kdurf15/KDurf-Senior-Design-Project/README.md

# KDurf-Senior-Design-Project
**DIGITAL SIMULATION**

For my (Kevin Durfee's) Senior Design project, I have created and implemented an educational simulation of the Safety Loop system for the FSAE EV cars, based on the 2023 Formula Hybrid SAE + Electric ruleset. 

Shown below is the FSM Diagram for the Safety Loop system, with the omission of lights/sounds. Along with it is the state transition table for the respective FSM. 

<p align="center">
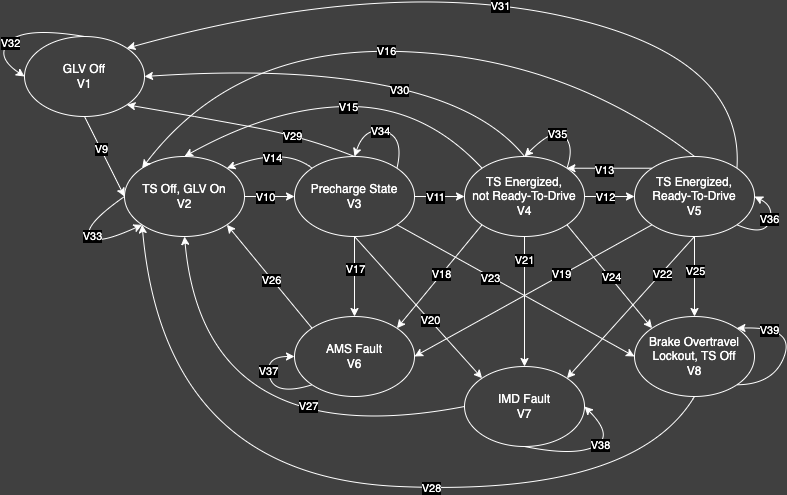
[picture p1: Safety Loop (re-colored for transparent github background).png]
Safety Loop (re-colored for transparent github background)



</p>

For those still learning about the FSAE EV Safety Loop system, or is new to the Lafayette Motorsports Team, I've provided a legend/key that explains the jargon I used.

<p align="center">

</p>

To further help understand the State Transition Table, as well as the javascript used to create the simulation, I have provided a table that briefly explains the FSM Boolean Logic used and a Truth Table that provides further examples on this Boolean Logic.

<p align="center">



</p>

Provided below is a simplified table, to help elaborate on and explain the necessary steps to transition between states and get the car ready to drive while complying with the Safety Loop/Shutdown Circuit.

<p align="center">

</p>

To provide further elaboration on the table above and create a better understanding of the simulation, there are a few features present in the simulation (either loosely explained or not explained above) that I'd like the describe. The first being the Ready-To-Drive Sound. The Ready-To-Drive Sound is 80 dbA sound that lasts for 2 seconds, that signifies that the car is ready to drive (meaning the simulation have left the TS Energized, Not Ready-To-Drive state and has entered the TS Energized, Ready-To-Drive state). This sound/buzzer is required on the car, as outlined in EV9.2 of the 2023 Formula Hybrid + Electric Rules and occurs in the simulation (hence it is encouraged to have the computer's sound on when using the simulation). Separately, in the event of any fault occuring on the car (either AMS, IMD, or Brake Overtravel Lockout), the Safety Loop/Shutdown Circuit is triggered. This results in the car, and hence the simulation, disengaging the tractive system and only keeping the GLV system on (entering the TS Off, GLV On sate). This is done for the protection of high/tractive system voltage for the driver, team, or bystanders. The GLV system remains on/energized, as it is used to power the Safety Loop/Shutdown Circuit. To help correct the car/re-energize it, all live voltage systems should bew shutdown and disengaged prior to examing the cause of the fault. Once the cause of the fault is found, the system can be re-energized using the previously outlined steps/procedures. For the simulation, if a fault occurs/fault button is engaged, the simulaton returns to the TS Off, GLV On state. From there, disengage the motor controller switch, the cockpit BRB and the TSMS. To re-energize the car, "correct/fix" the "faults" by disenganging the respective fault buttons, then procede to re-energize the car with the same steps from the TS Off, GLV On state as before.

For further clarification of the simulation, below indicates the button's appearances for the "engaged" and "not engaged" states.

<p align="center">
BRB BUTTONS
</p>

<p align="center">
  NOT ENGAGED
Safety Loop (re-colored for transparent github background)
Safety Loop (re-colored for transparent github background)
  ENGAGED
</p>

<p align="center">
GREEN BUTTONS (NON-BRB)
</p>

<p align="center">
  NOT ENGAGED
Safety Loop (re-colored for transparent github background)
Safety Loop (re-colored for transparent github background)
  ENGAGED
</p>

For ease of access, the educational Safety Loop simulation can be found here: https://kdurf15.github.io/KDurf-Senior-Design-Project/

For ease of access, the screenshot of the Safety Loop simulation 

A photo of the educational Safety Loop simulation is shown below. For ease of access, the below photo serves as a hyperlink to the simulation itself.

<p align="center">
  
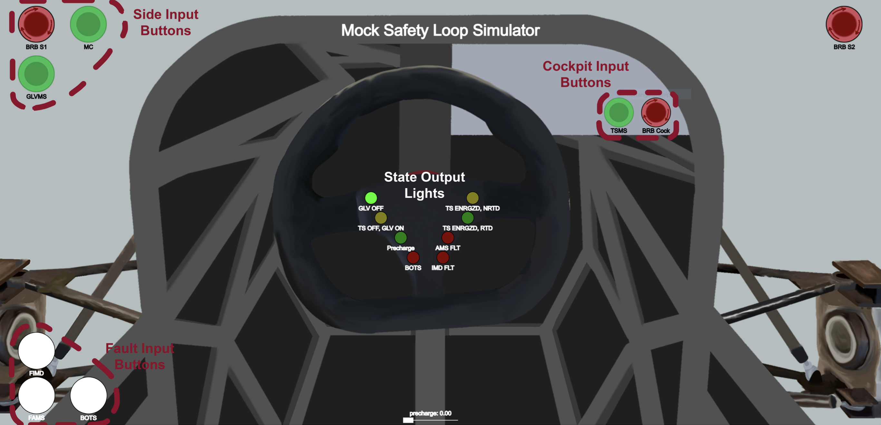
[picture p2: Labeled Sim Photo.png]
  
       
CONSIDER SWAPPED FOR NON-LABELED PHOTO FROM DESKTOP
</p>

**HARDWARE IMPLEMENTATION**

In addition to the digital/virtual simulation, I have created a physical small-scale version of the Shutdown Circuit. All features and hardware that would be on the actual Lafayette Motorsports FSAE EV car are present on the PCB test rig, just scaled down. The only exception to this would be the faults (BOTS, IMD, and AMS), which are represented via latching switches (similarly to the digital/virtual simulation). The PCB Safety Loop/Shutdown Circuit tool uses 3V and 9V batteries, on separate paths, to mimic the grounded low voltage (GLV) and tractive system (TS) of the car.

The first step when creating this PCB was to design the pre-charge circuit and circuit diagram. As a reminder, the pre-charge circuit works to prevent a sudden spike in current that would result in welding the AIRs shut (live). The time duration for the pre-charge relay, determined to be approximately 3 seconds (5 time constants), are shown below.

<p align="center">
  Target of ~99.3% Charge in 5 time constants (3 seconds)
</p>

<p align="center">
  5𝜏 = 3 seconds   →   𝜏 = 0.6 seconds
</p>

<p align="center">
  𝜏 = RC
</p>
  
<p align="center">
  Motor Inverter DC Bus Capacitance, C = 300 μF
</p>

<p align="center">
  R = 𝜏/C = (0.6 seconds)/(300 μF) = 2kΩ
  
</p>

<p align="center">
  Max current target, based on full ~300V
</p>
<p align="center">
  (300V)/(2 kΩ) = 0.15 A
  
</p>

<p align="center">
  Power Dissipated through Resistor
</p>

<p align="center">
  (0.15^2 A)*(2 kΩ) = 45 W Max
</p>

The pre-charge time delay, both for the small-scale PCB safety loop implementation and the physical implementation in the full-scale car, will use a 555 timer. The safety loop circuit, including the 555 timer, was initially designed in falstad. The falstad is shown below and can be found here: https://tinyurl.com/ctu5a7be

<p align="center">
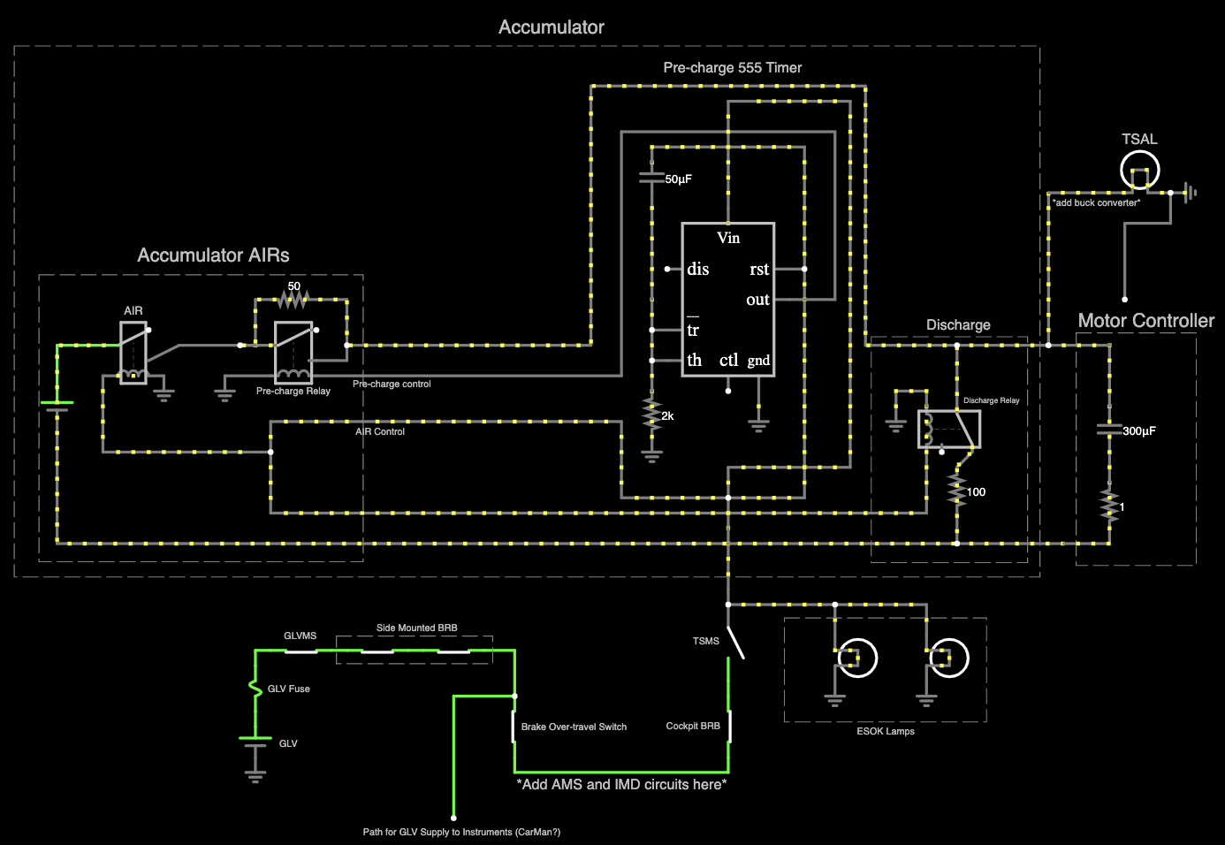
[picture p3: falstad screenshot.png]
falstad screenshot

</p>

As required by the 2023 Formula SAE Hybrid + Electric rule set, the Isolation Monitoring Device (IMD) and Accumulator Management System (AMS) require latching circuits for the faults. Two suggested designs, for either fault low or high, are provided in the Appendix G of the rules and is shown below.

<p align="center">
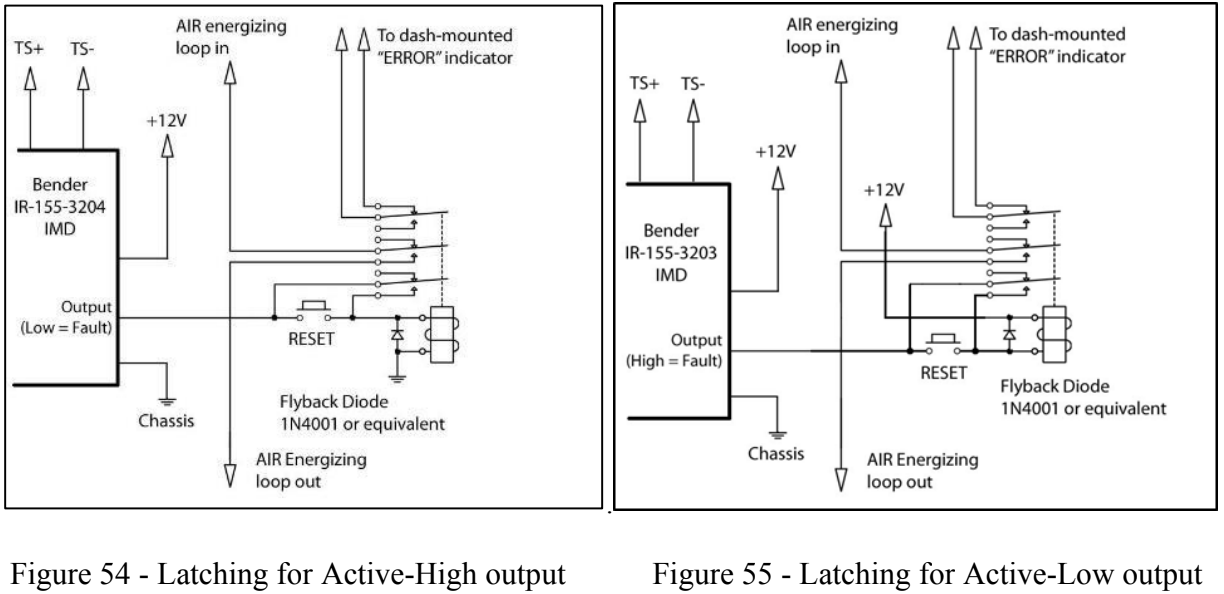
[picture p4: Appendix G Latching Circuit.png]
Falstad Latching Circuit
  
</p>

This design was considered and the corresponding design was completed in falstad. The "fault" was considered/modeled as a latching switch. The falstad is not fully rules-compliant, as it needs the addition of a flyback diode, as shown in the rules. The falstad design is shown below and can be found here: https://tinyurl.com/23wacp5r

<p align="center">
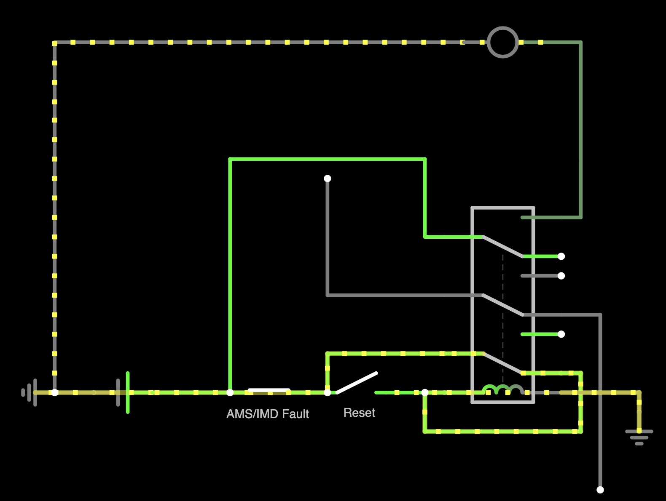
[picture p5: Falstad Latching Circuit.png]
Falstad Latching Circuit
  
</p>

The latching circuit used on the Safety Loop/Shutdown Circuit Educational PCB is simplified to the reset latching portion, providing "feedback" to require the reset switch. Given that the PCB is wired in series, pressing the fault button to simulate a fault shutdown. Due to the tactile connection of creating a fault with the fault button, a fault LED signal was not included.

This, along with the entirity of the Safety Loop/Shutdown Circuit system, was then implemented onto a PCB with silk screens to illustrate the specific wiring path, for ease of learning and understanding. A picture of the PCB design is shown below. Fusion 360 and Eagle schematic files can be found in the compressed folder, "Shutdown Circuit PCB Schematic Files," which is permalinked here: https://github.com/kdurf15/KDurf-Senior-Design-Project/blob/f66a77cbe09608431833e2ea92ca653daefc6d79/Shutdown%20Circuit%20PCB%20Schematic%20Files.zip

Below is a photo of the PCB Schematic, both normal and trimmed nets

<p align="center">
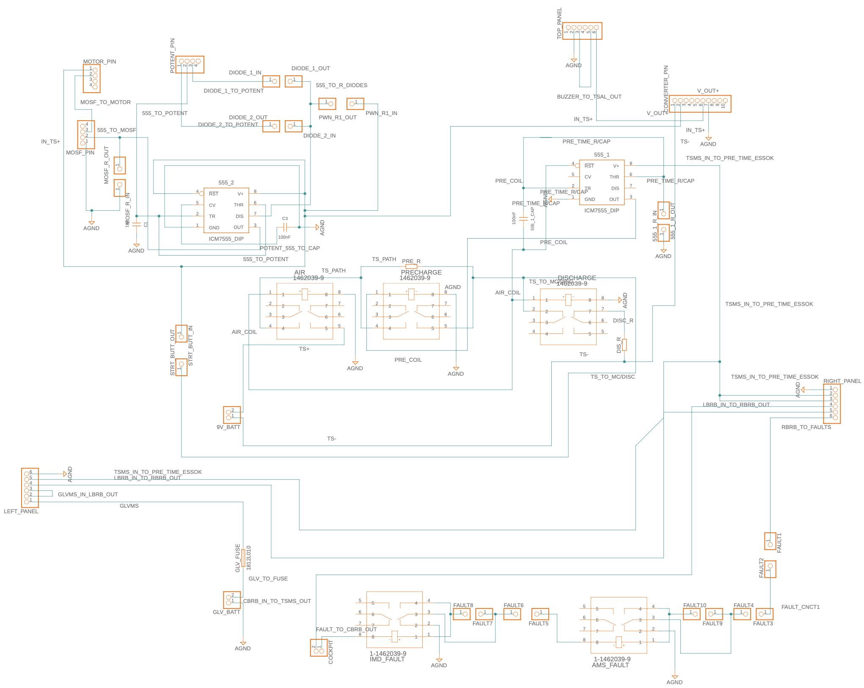
[picture p6: PCB Schematic.png]
PCB Schematic
  
</p>

<p align="center">
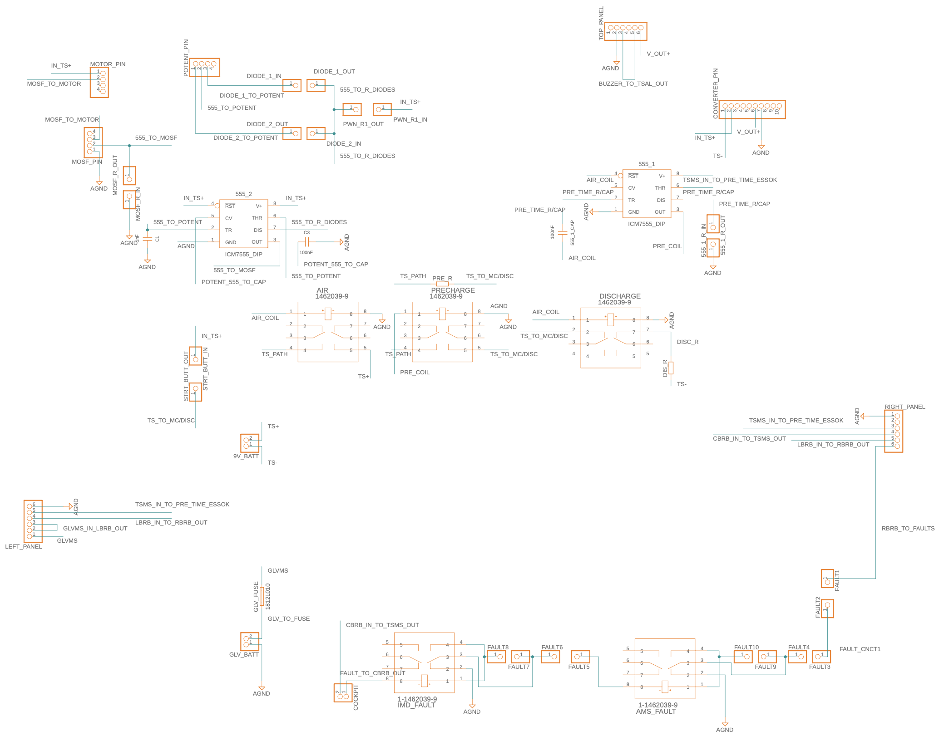
[picture p7: PCB Schematic Trimmed.png]
PCB Schematic Trimmed
  
</p>

Below shows the PCB silkscreen and physical board layout, based on the previously showed schematic

<p align="center">
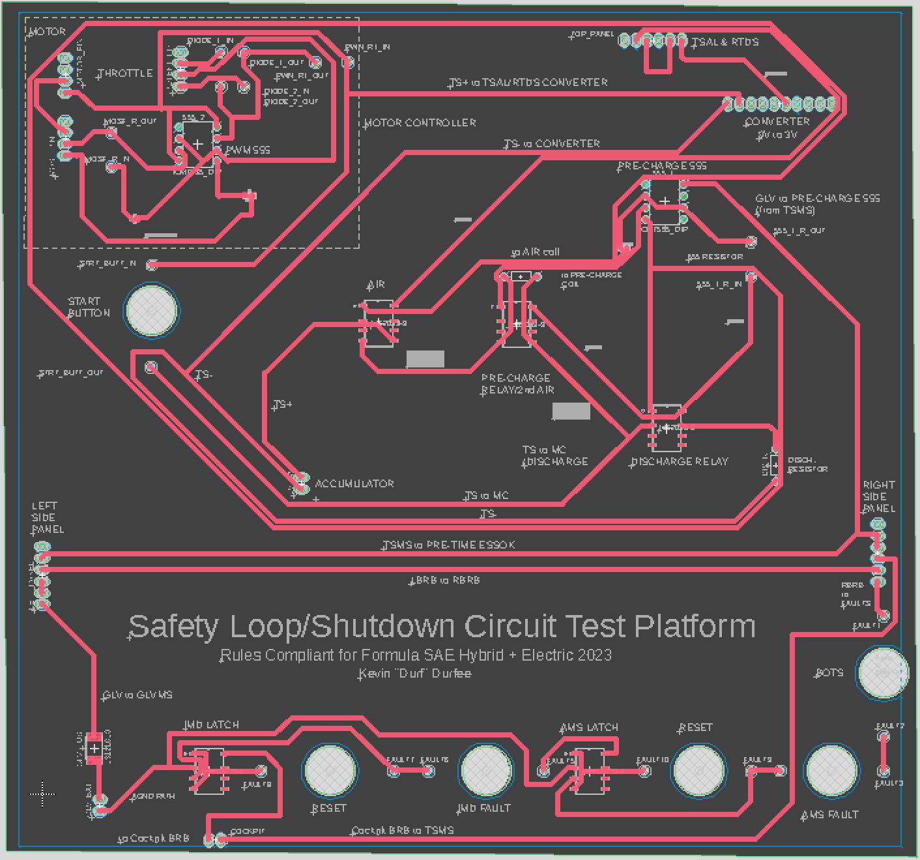
[picture p8: PCB Layout Photo.png]
PCB Layout Photo
  

</p>

<p align="center">
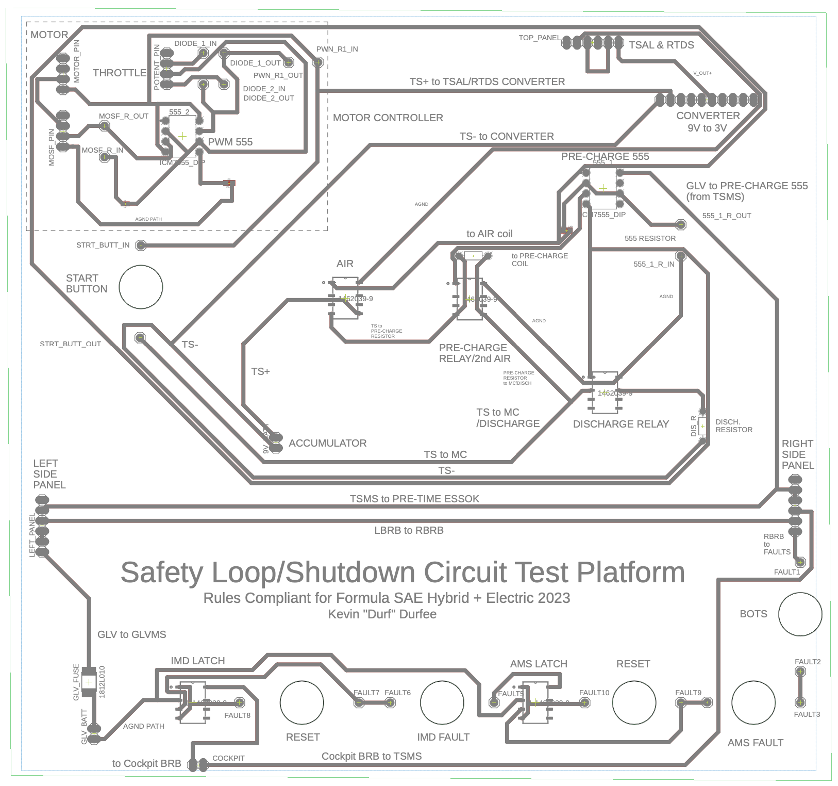
[picture p9: Silk Screen PCB Schematic.png]
Silk Screen PCB Schematic
  

</p>

Photos of the 3D model of the above PCB are shown below.

<p align="center">
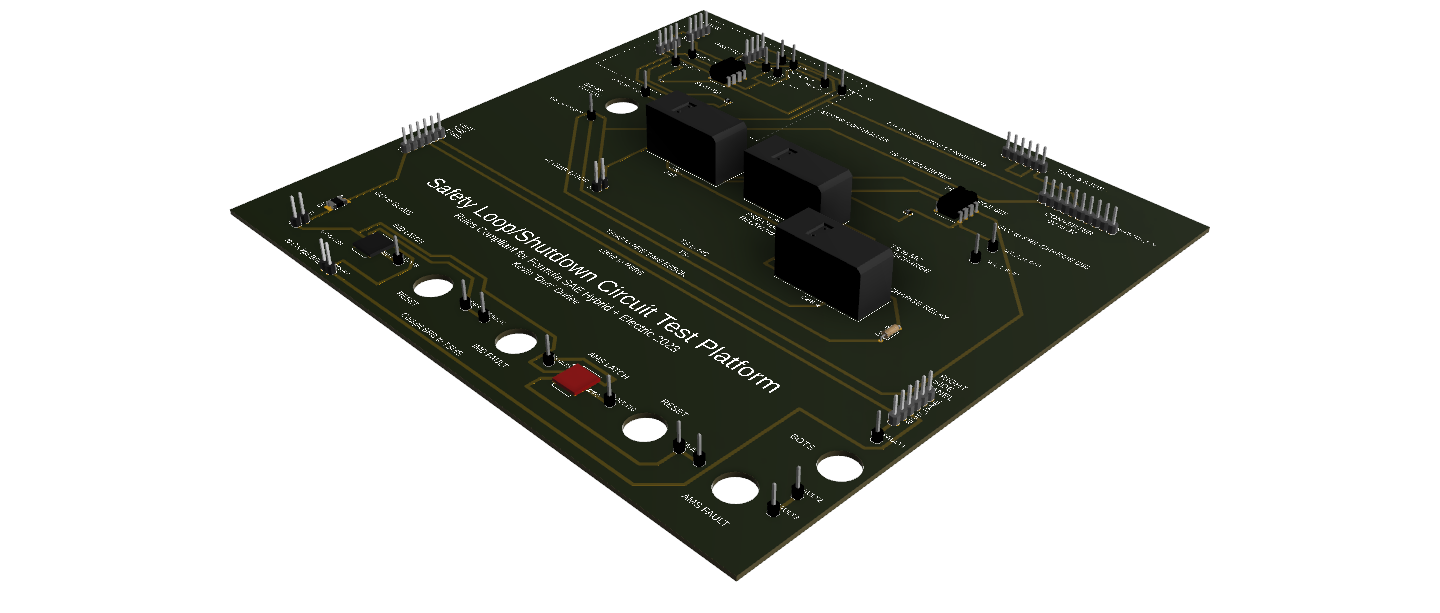
[picture p10: Durfee Safety Loop 3D PCB Photo.png]
Durfee Safety Loop 3D PCB Photo
  
</p>

<p align="center">
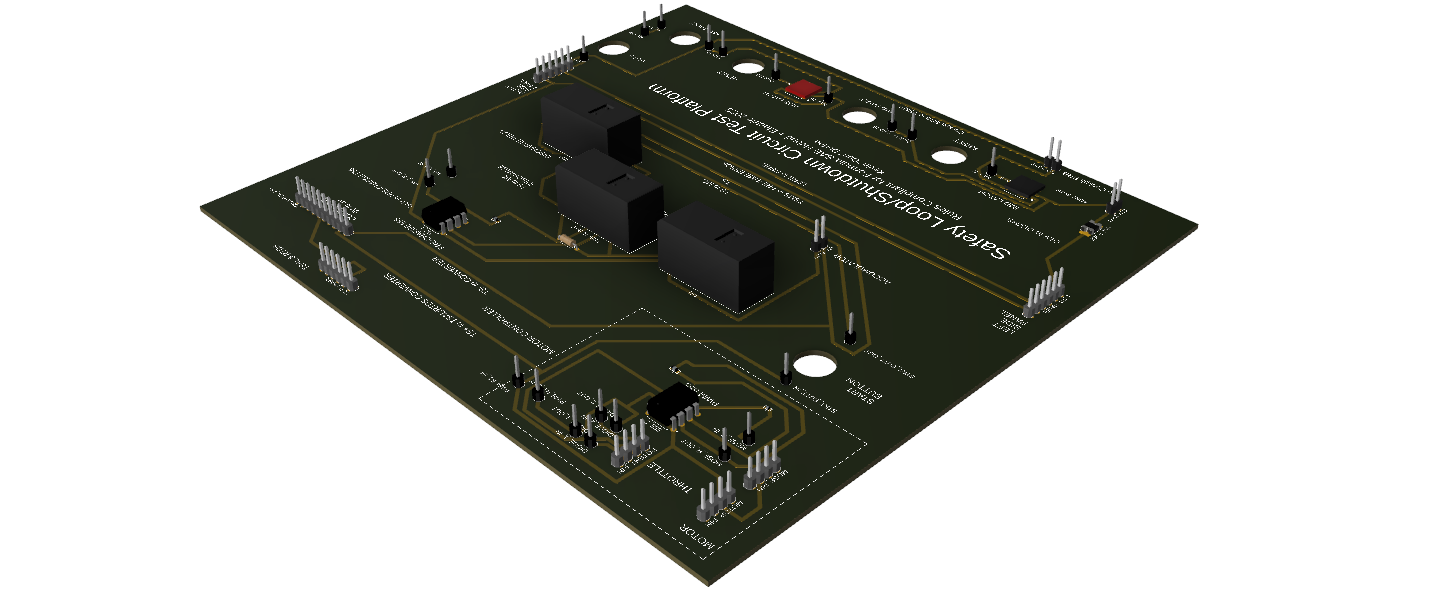
[picture p11: Durfee Safety Loop 3D PCB Photo 2.png]
Durfee Safety Loop 3D PCB Photo 2
  
</p>

For the small-scale Safety Loop/Shutdown Circuit PCB tool to appear more similar to the car's layout, buttons and switches were respectively mounted on 3D-printed "side panels" or "cockpit panels," similar to those on the car. Attachments for the rotary switches were also printed to mimic the red GLV and TS master switches. All .stl files for the 3D-printed designs are uploaded and can be found in the CAD Assembly STL Files.zip file. The completed PCB Safety Loop/Shutdown Circuit education tool is shown below.

<p align="center">
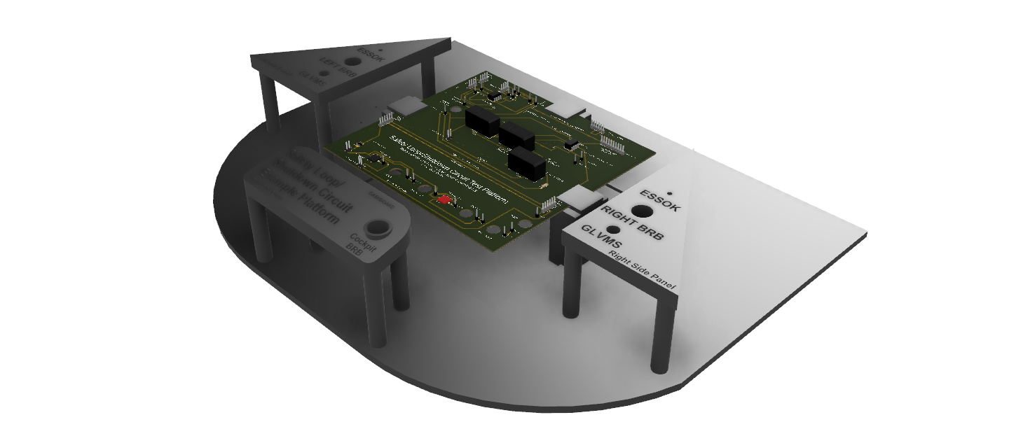
[picture p12: 3D Printed Layout.png]

</p>

After construction of the PCB, testing to check the functionality occured. Without having the proper relays in hand for the fault latching circuits, 5V relays from the 2022 ME480 Lab Rig were used. These created a significant voltage drop, causing the Safety Loop/Shutdown Circuit system to not work. Once this was bypassed, the ESSOK lights would ignite and work as intended. However, this resulted in the loss of functionality for the AMS Fault or IMD Fault buttons/features. Besides that, moving into the "high voltage" (9V) portion, I evaluated the AIRs. As seen in the wiring schematic, the Pre-Charge relay, AIR, and Discharge relay appear to be wired on the PCB incorrectly. Once corrected, by switching the connection from pad 5 to pad 2 on the Pre-Charge Relay, for example, these should work as intended. By sending the 9V+ directly after the start button, the motor and PWM Potentiometer "Motor Controller" was also tested. Despite the motor reciving approximately 9V, the motor was not spinning. Further testing to evaluate the "Motor Controller" and the pperability of the motor must occur to further find the respective issue. Below please find a photo of the first iteration of the PCB and the test rig.

<p align="center">
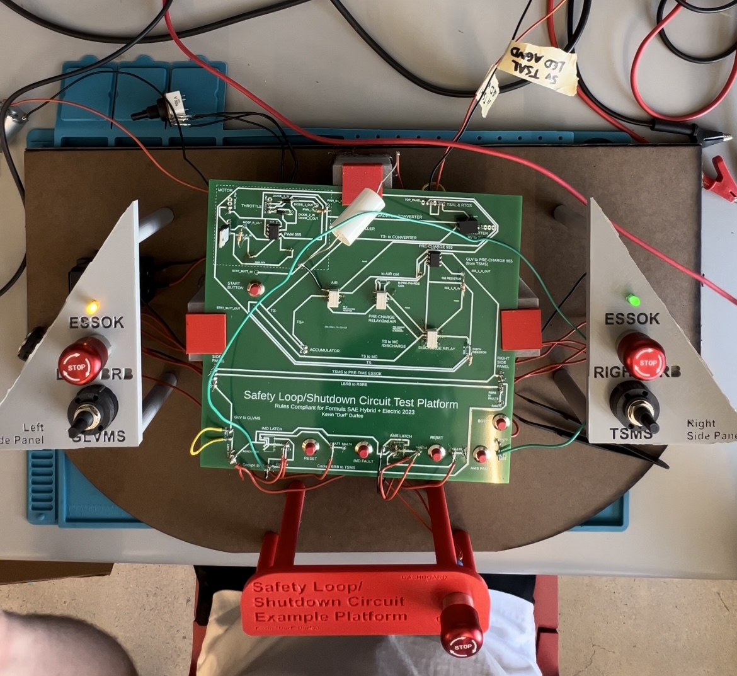
[picture p13: TestRig.jpg]
Test Rig

</p>

If any issues or questions arise with the code/simulation/hardware/project, please feel free to contact me (Kevin/Durf) at kdurf15@comcast.net or durfeekd@lafayette.edu (if my Lafayette email address is still active).
