kdurf15/KDurf-Senior-Design-Project/Sim Placeholder Image.png

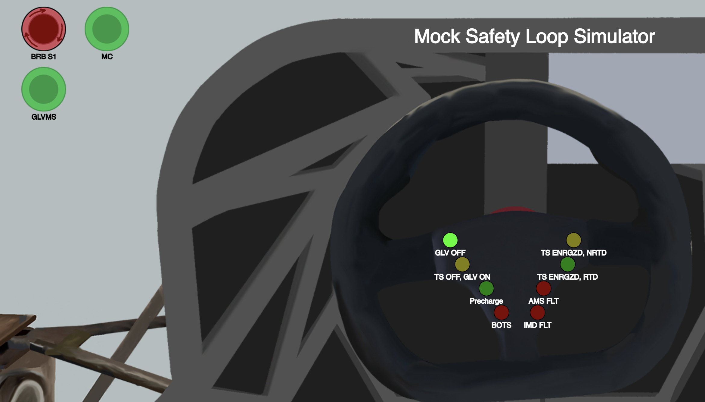
Sim Placeholder Image.png
