kdurf15/KDurf-Senior-Design-Project/Durfee_Shutdown_Circuit_PCB_Design.sch

## EAGLE design Durfee_Shutdown_Circuit_PCB_Design.sch (2023-04-27, last stored version)

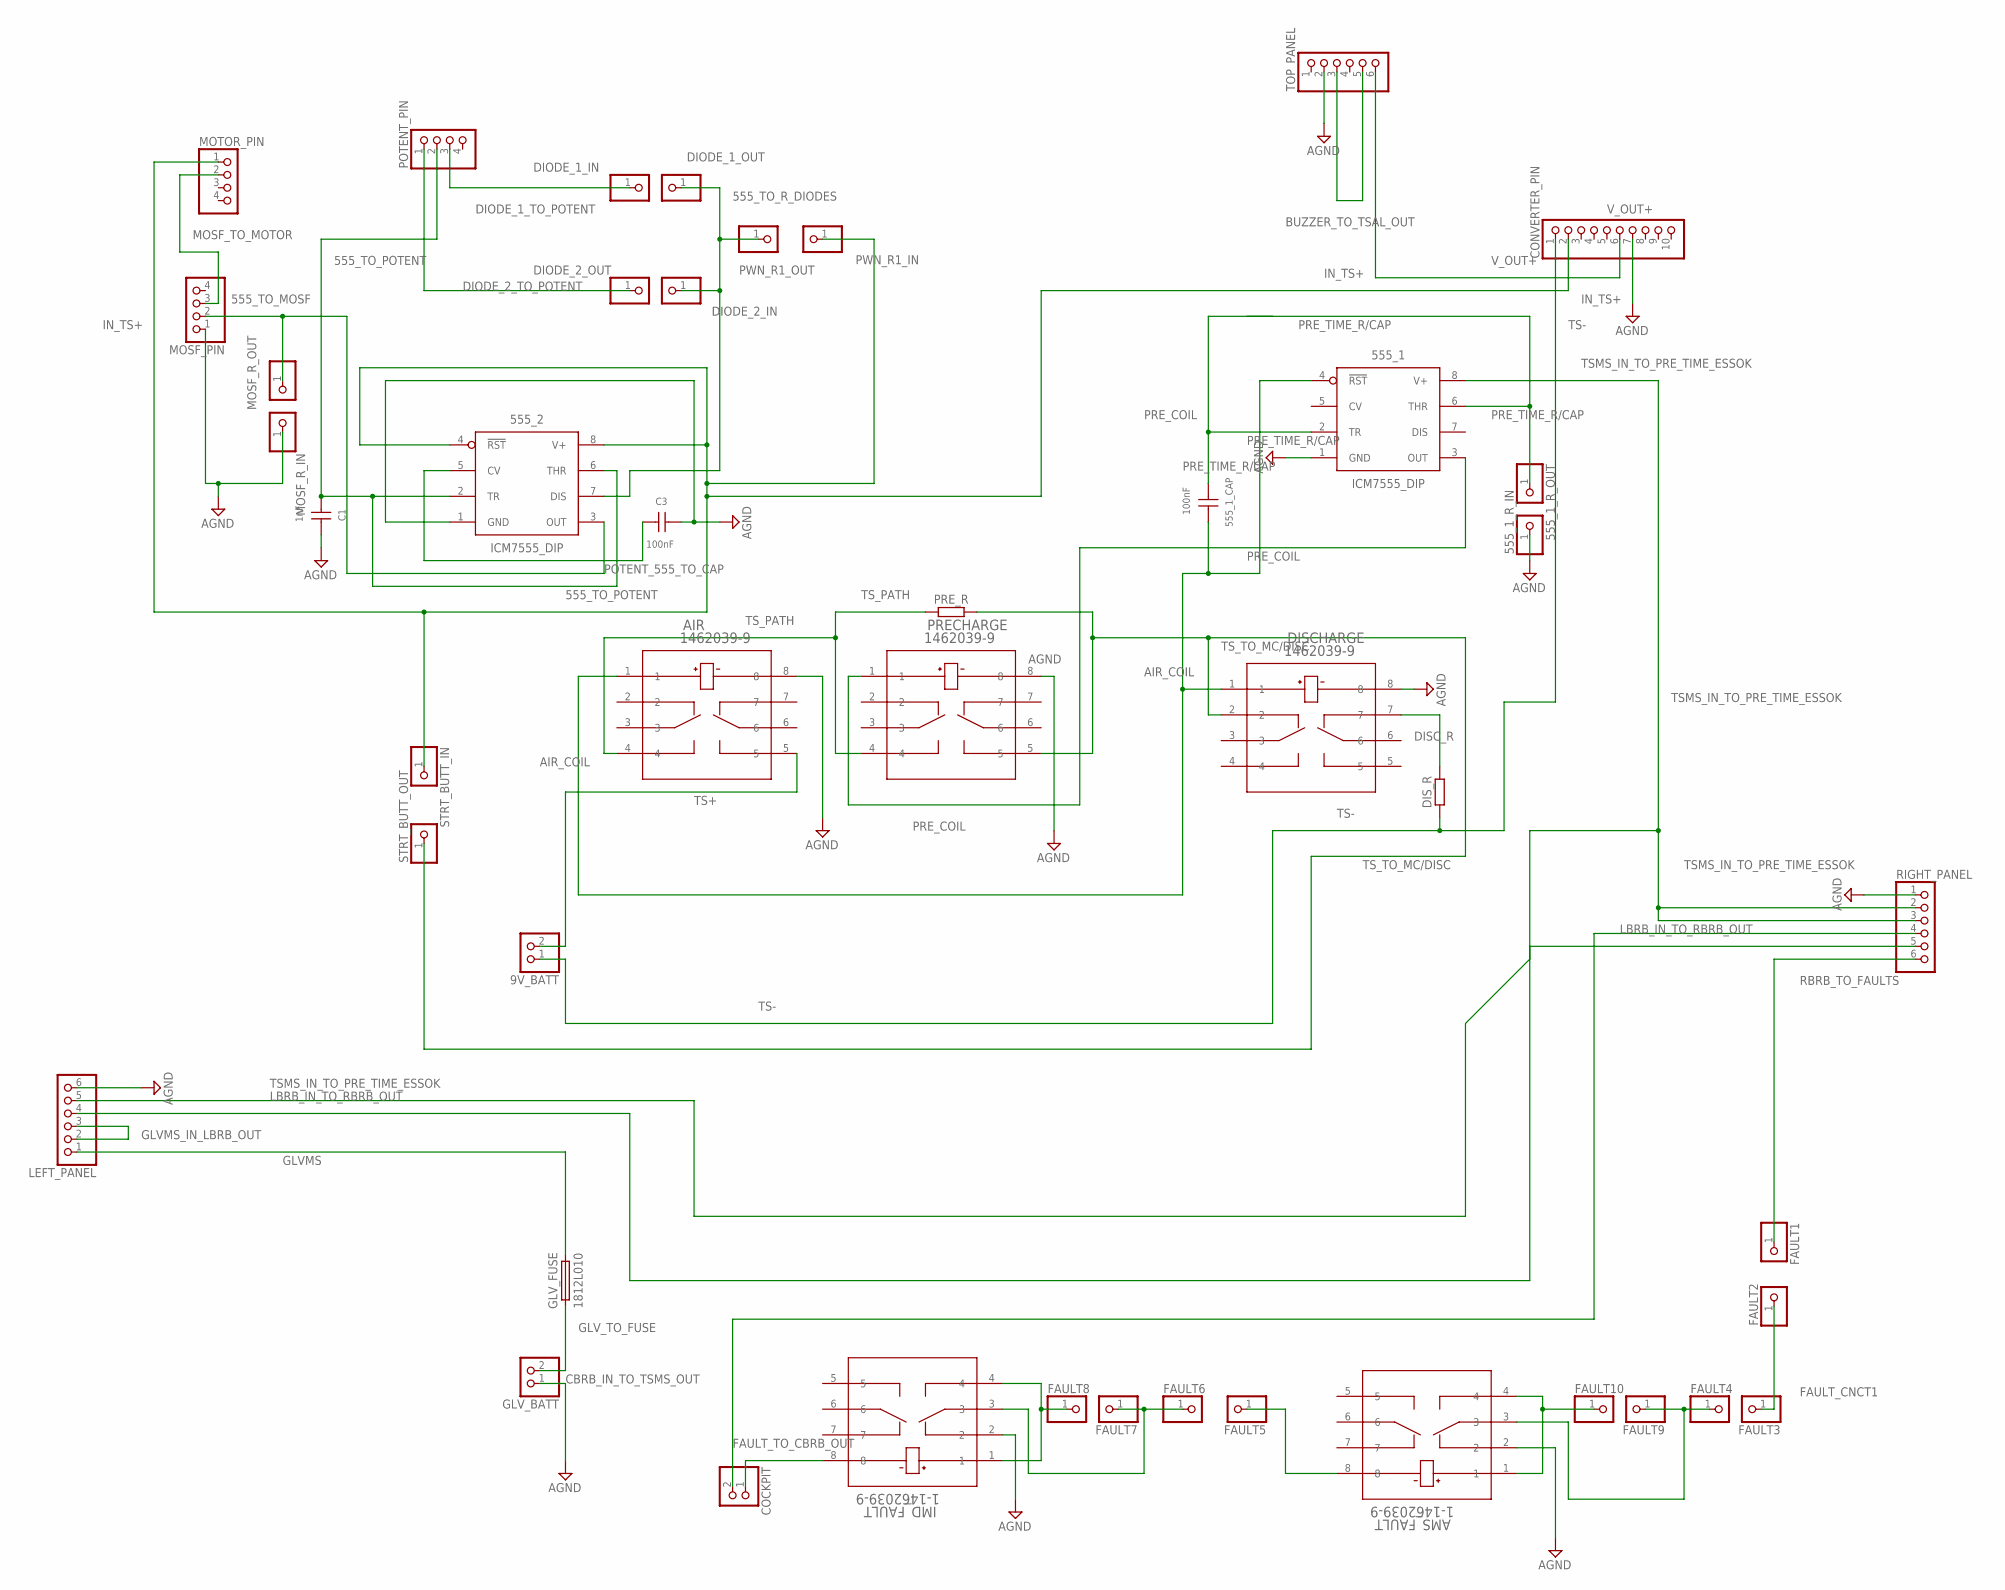
[picture p15: schematic Durfee_Shutdown_Circuit_PCB_Design.sch]

Parts:
9V_BATT: PINHD-1X2; 1X02
555_1, 555_2: ICM7555_DIP; DIP826W53P254L959H508Q8B
555_1_CAP: 100nF; WCAP-CSGP_0603_R
555_1_R_IN, 555_1_R_OUT: PINHD-1X1; 1X01
AIR: 1462039-9; RELAY8_SMTGUL
AMS_FAULT: 1-1462039-9; RELAY8_SMTGUL
C1: 1nF; WCAP-CSGP_0402
C3: 100nF; WCAP-CSGP_0603_R
COCKPIT: PINHD-1X2; 1X02
CONVERTER_PIN: PINHD-1X10; 1X10
DIODE_1_IN, DIODE_1_OUT, DIODE_2_IN, DIODE_2_OUT: PINHD-1X1; 1X01
DISCHARGE: 1462039-9; RELAY8_SMTGUL
DIS_R: R_AXIAL-7.2MM-PITCH; RESAD724W46L381D178B
FAULT1, FAULT2, FAULT3, FAULT4, FAULT5, FAULT6, FAULT7, FAULT8, FAULT9, FAULT10: PINHD-1X1; 1X01
GLV_BATT: PINHD-1X2; 1X02
GLV_FUSE: 1812L010; FUSC4532X125
IMD_FAULT: 1-1462039-9; RELAY8_SMTGUL
LEFT_PANEL: PINHD-1X6; 1X06
MOSF_PIN: PINHD-1X4; 1X04
MOSF_R_IN: PINHD-1X1; 1X01
MOSF_R_OUT: PINHD-1X1; 1X01
MOTOR_PIN: PINHD-1X4; 1X04
POTENT_PIN: PINHD-1X4; 1X04
PRECHARGE: 1462039-9; RELAY8_SMTGUL
PRE_R: R_AXIAL-7.2MM-PITCH; RESAD724W46L381D178B
PWN_R1_IN, PWN_R1_OUT: PINHD-1X1; 1X01
RIGHT_PANEL: PINHD-1X6; 1X06
STRT_BUTT_IN: PINHD-1X1; 1X01
STRT_BUTT_OUT: PINHD-1X1; 1X01
TOP_PANEL: PINHD-1X6; 1X06

Connections:
555_TO_MOSF: 555_2.3 (OUT), MOSF_PIN.2, MOSF_R_OUT.1
555_TO_POTENT: 555_2.2 (TR), 555_2.6 (THR), C1.1, POTENT_PIN.2
555_TO_R_DIODES: 555_2.7 (DIS), DIODE_1_OUT.1, DIODE_2_IN.1, PWN_R1_OUT.1
AGND: 555_1.1 (GND), 555_1_R_IN.1, 555_2.1 (GND), AIR.8, AMS_FAULT.2, C1.2, C3.2, CONVERTER_PIN.7, DISCHARGE.8, GLV_BATT.1, IMD_FAULT.2, LEFT_PANEL.6, MOSF_PIN.1, MOSF_R_IN.1, PRECHARGE.8, RIGHT_PANEL.1, TOP_PANEL.2
AIR_COIL: 555_1.4 (!RST), 555_1_CAP.2, AIR.1, DISCHARGE.1
BUZZER_TO_TSAL_OUT: TOP_PANEL.3, TOP_PANEL.5
CBRB_IN_TO_TSMS_OUT: COCKPIT.2, RIGHT_PANEL.4
DIODE_1_TO_POTENT: DIODE_1_IN.1, POTENT_PIN.3
DIODE_2_TO_POTENT: DIODE_2_OUT.1, POTENT_PIN.1
DISC_R: DISCHARGE.7, DIS_R.2
FAULT_CNCT1: FAULT2.1, FAULT3.1
FAULT_TO_CBRB_OUT: COCKPIT.1, IMD_FAULT.8
GLVMS: GLV_FUSE.2, LEFT_PANEL.1
GLVMS_IN_LBRB_OUT: LEFT_PANEL.2, LEFT_PANEL.3
GLV_TO_FUSE: GLV_BATT.2, GLV_FUSE.1
IN_TS+: 555_2.4 (!RST), 555_2.8 (V+), CONVERTER_PIN.2, MOTOR_PIN.1, PWN_R1_IN.1, STRT_BUTT_IN.1
LBRB_IN_TO_RBRB_OUT: LEFT_PANEL.4, RIGHT_PANEL.5
MOSF_TO_MOTOR: MOSF_PIN.3, MOTOR_PIN.2
unnamed: FAULT8.1, IMD_FAULT.1, IMD_FAULT.4
unnamed: AMS_FAULT.3, FAULT4.1, FAULT9.1
unnamed: FAULT6.1, FAULT7.1, IMD_FAULT.3
unnamed: AMS_FAULT.8, FAULT5.1
unnamed: AMS_FAULT.1, AMS_FAULT.4, FAULT10.1
POTENT_555_TO_CAP: 555_2.5 (CV), C3.1
PRE_COIL: 555_1.3 (OUT), PRECHARGE.1
PRE_TIME_R/CAP: 555_1.2 (TR), 555_1.6 (THR), 555_1_CAP.1, 555_1_R_OUT.1
RBRB_TO_FAULTS: FAULT1.1, RIGHT_PANEL.6
TS+: 9V_BATT.2, AIR.5
TS-: 9V_BATT.1, CONVERTER_PIN.1, DIS_R.1
TSMS_IN_TO_PRE_TIME_ESSOK: 555_1.8 (V+), LEFT_PANEL.5, RIGHT_PANEL.2, RIGHT_PANEL.3
TS_PATH: AIR.4, PRECHARGE.4, PRE_R.1
TS_TO_MC/DISC: DISCHARGE.2, PRECHARGE.5, PRE_R.2, STRT_BUTT_OUT.1
V_OUT+: CONVERTER_PIN.6, TOP_PANEL.6
