kdurf15/KDurf-Senior-Design-Project/(commit log)

2022-10-11 changed precharge from timer to input
2022-10-11 updated title and text, struggling to get X6+ buttons true still
2022-10-11 omitted update button
2022-10-11 omitted timers and counters, reformated boxes around inputs and outputs
2022-10-21 implemented precharge timer on a 10second timer based system, with the precharge circuit reaching 90% at 9seconds
