kdurf15/KDurf-Senior-Design-Project/(notices)

Notices in the files:
parts and their libraries:
Relays: COPYRIGHT: Copyright (C) 2016 Accelerated Designs. All rights reserved
Wurth_Capacitors_WCAP-CSGP: Copyright: Würth Elektronik
